Joozd/GarageVentilation/hardware/GarageVentilation_v1.kicad_pcb

## KiCad design hardware/GarageVentilation_v1.kicad_pcb (2026-11-04)

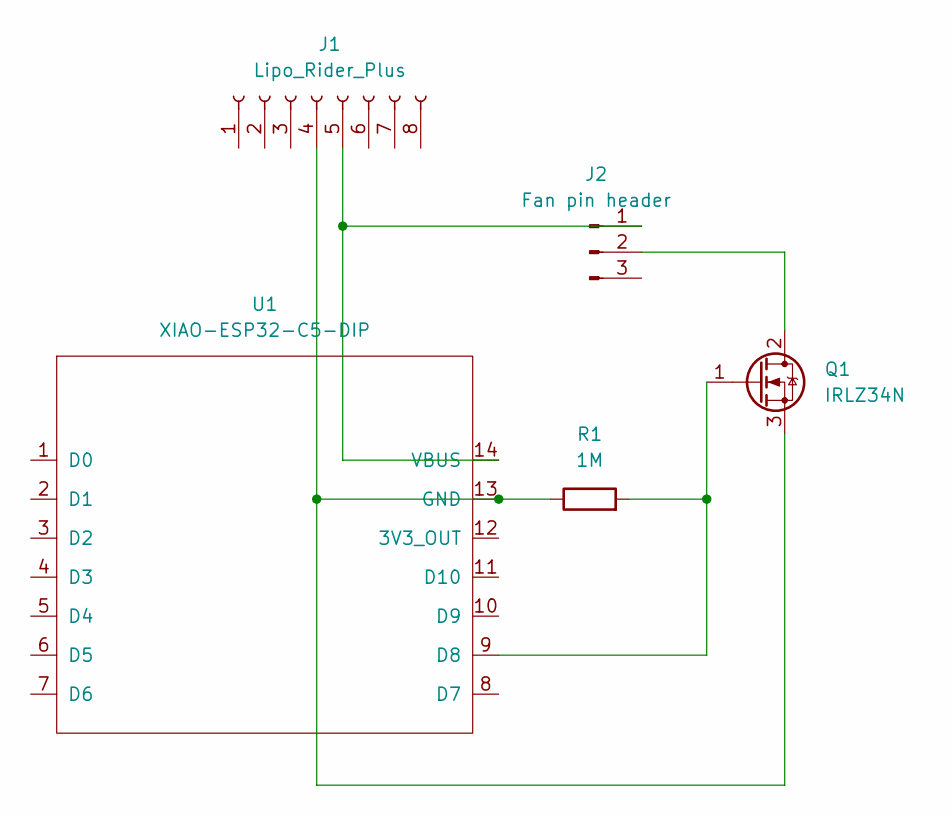
[picture p1: schematic GarageVentilation_v1.kicad_sch]

Parts:
J1: Lipo_Rider_Plus; LiPo_Rider_Plus
J2: Fan pin header; FanPinHeader_1x03_P2.54mm_Vertical
Q1: IRLZ34N; TO-220-3_Vertical
R1: 1M; R_Axial_DIN0207_L6.3mm_D2.5mm_P7.62mm_Horizontal
U1: XIAO-ESP32-C5-DIP; XIAO-ESP32-C5-DIP_mount

Connections:
unnamed: J1.5 (5V), J2.1, U1.14 (VBUS)
unnamed: J2.2, Q1.2 (D)
unnamed: Q1.1 (G), R1.2, U1.9 (D8)
unnamed: J1.4 (GND), Q1.3 (S), R1.1, U1.13 (GND)

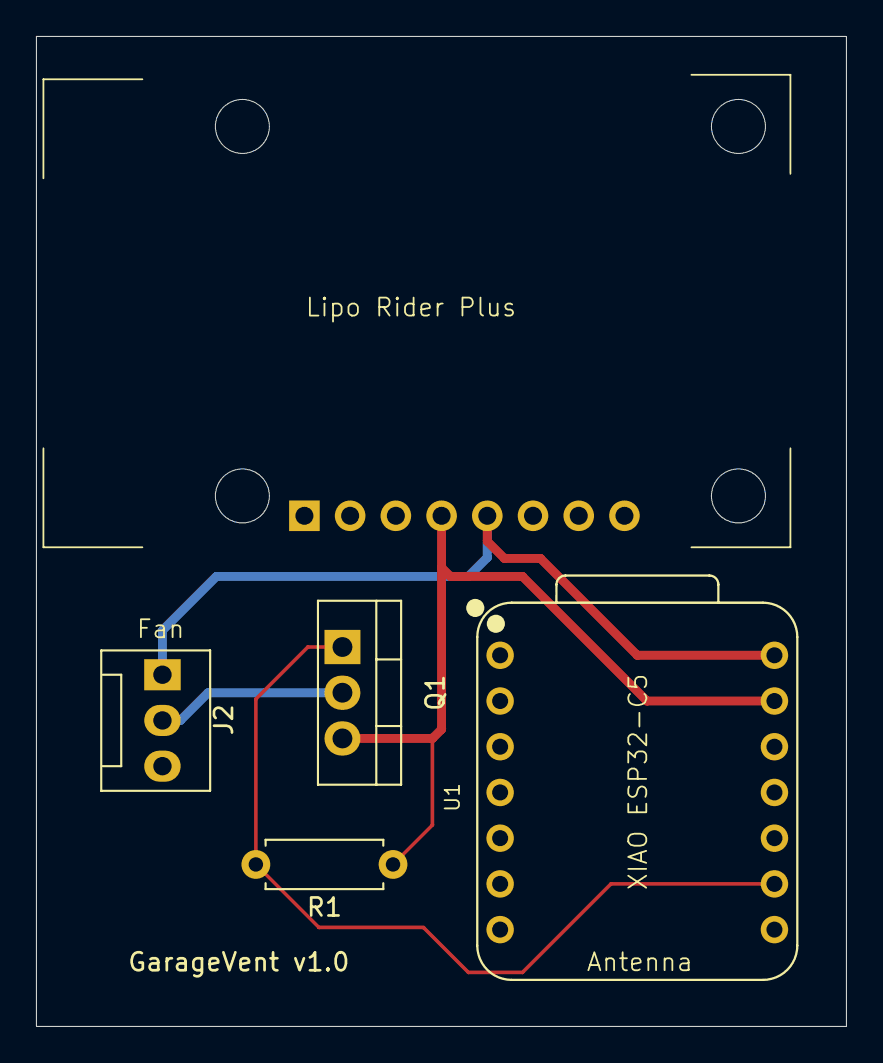
[picture p2: board GarageVentilation_v1.kicad_pcb from above]

Board: 2 copper layers, 45.0 x 55.0 mm, 5 parts (0 on the bottom side), 4 nets.
